yusufselimkaratas/463HardwareProject/README.md

# 463HardwareProject
Hardware Project Repository for EE 463 Hardware Project 

YouTube Link: https://youtu.be/oLoTbArwjGo
