yusufselimkaratas/463HardwareProject/SimResult.png

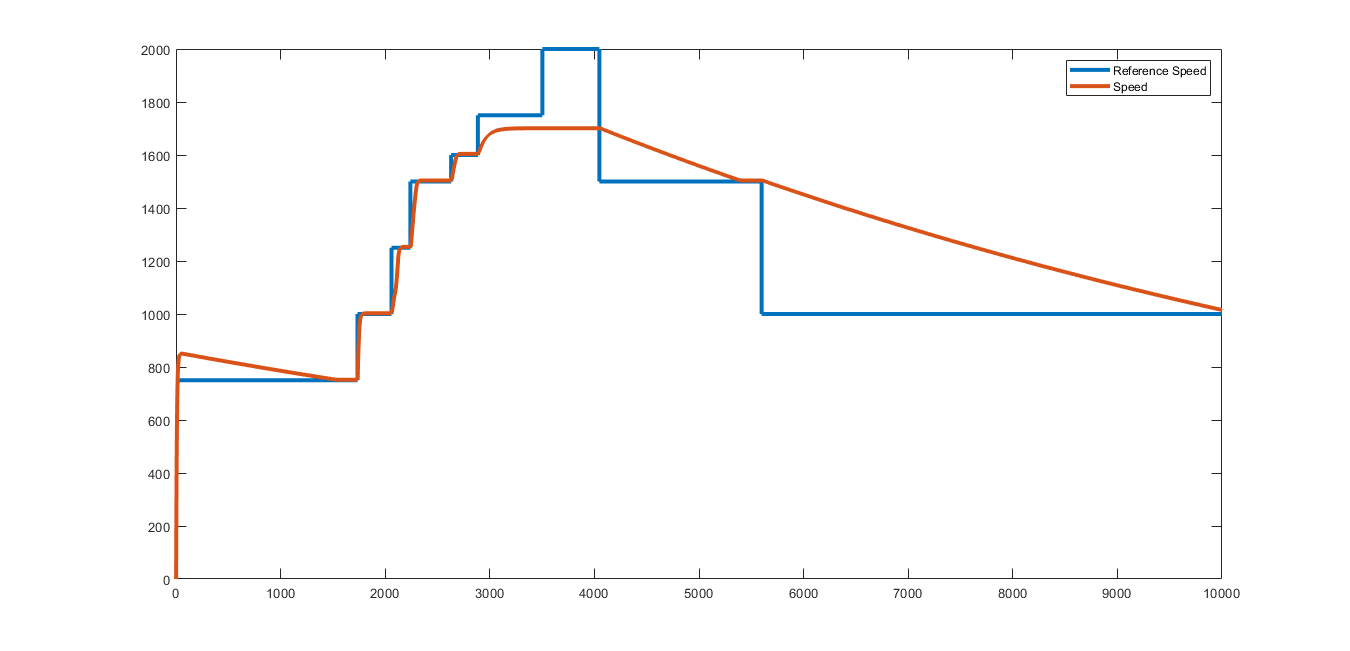
SimResult.png
