yusufselimkaratas/463HardwareProject/(commit log)

2018-12-30 Arduino Code has been uploaded
2018-12-30 Interrupt has been added.
2019-01-03 Schematic rearranged torque applyd 2 see ia change
2019-01-14 Interrupt and PID have been verified and checked
